tudsat-rocket/frodo_recovery_module/README.md

# Frodo Recovery Module

# Setup

Requires KiCAD version >= 6.0. To generate BOM, install the Interactive HTML BOM plugin: https://github.com/openscopeproject/InteractiveHtmlBom
