tudsat-rocket/frodo_recovery_module/ul_INA350ABSIDSGR/STEP/DSG0008A.stp

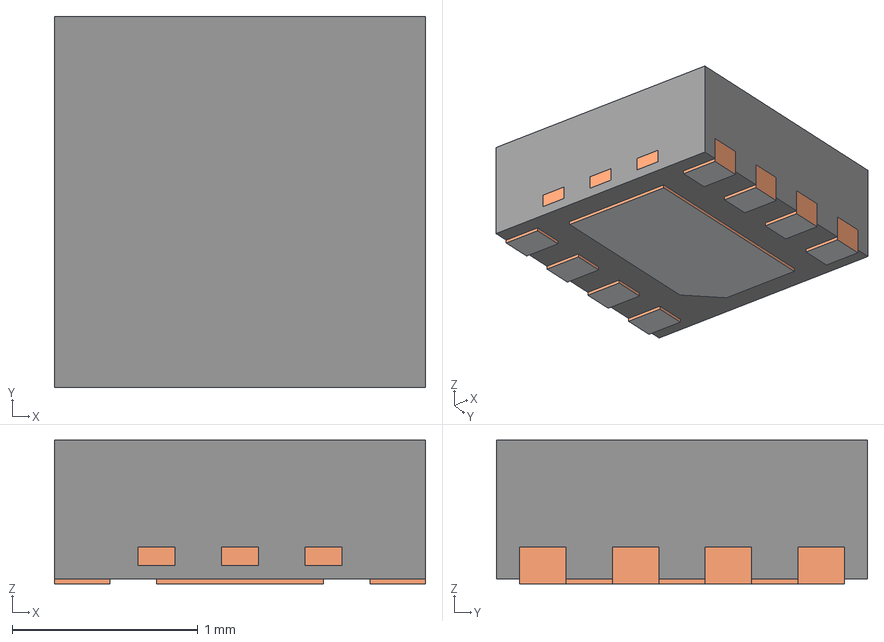
[picture p1: CAD file, 2023-07-11]
ul_INA350ABSIDSGR/STEP/DSG0008A.stp
2.00 x 2.00 x 0.775 mm
BODY-SON
FRAME-DSG0008A
PIN1-ID
