tudsat-rocket/frodo_recovery_module/3dmodels/EVQ-PUC02K.step

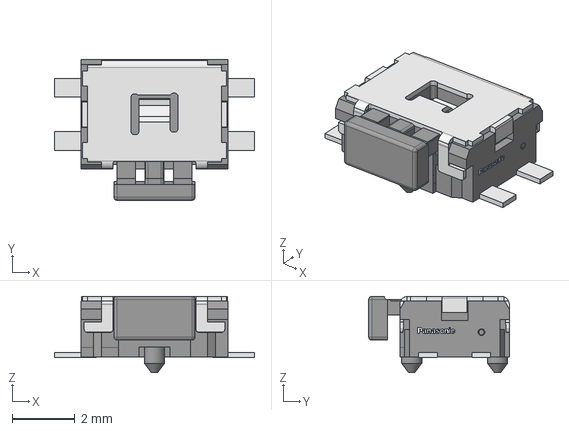
[picture p2: CAD file, 2023-07-11]
3dmodels/EVQ-PUC02K.step
6.40 x 4.50 x 2.44 mm
