tudsat-rocket/frodo_recovery_module/3dmodels/430450483.stp

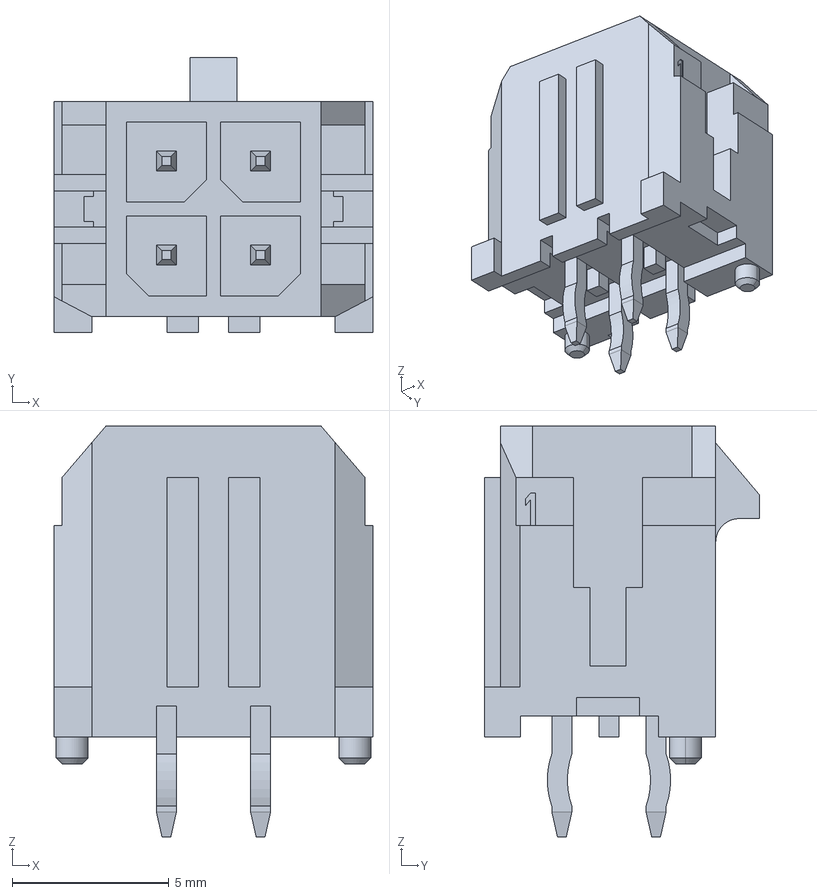
[picture p3: CAD file, 2023-07-11]
3dmodels/430450483.stp
10.2 x 8.77 x 13.1 mm
