tudsat-rocket/frodo_recovery_module/Recovery.kicad_pcb

## KiCad design Recovery.kicad_pcb (2023-07-17)

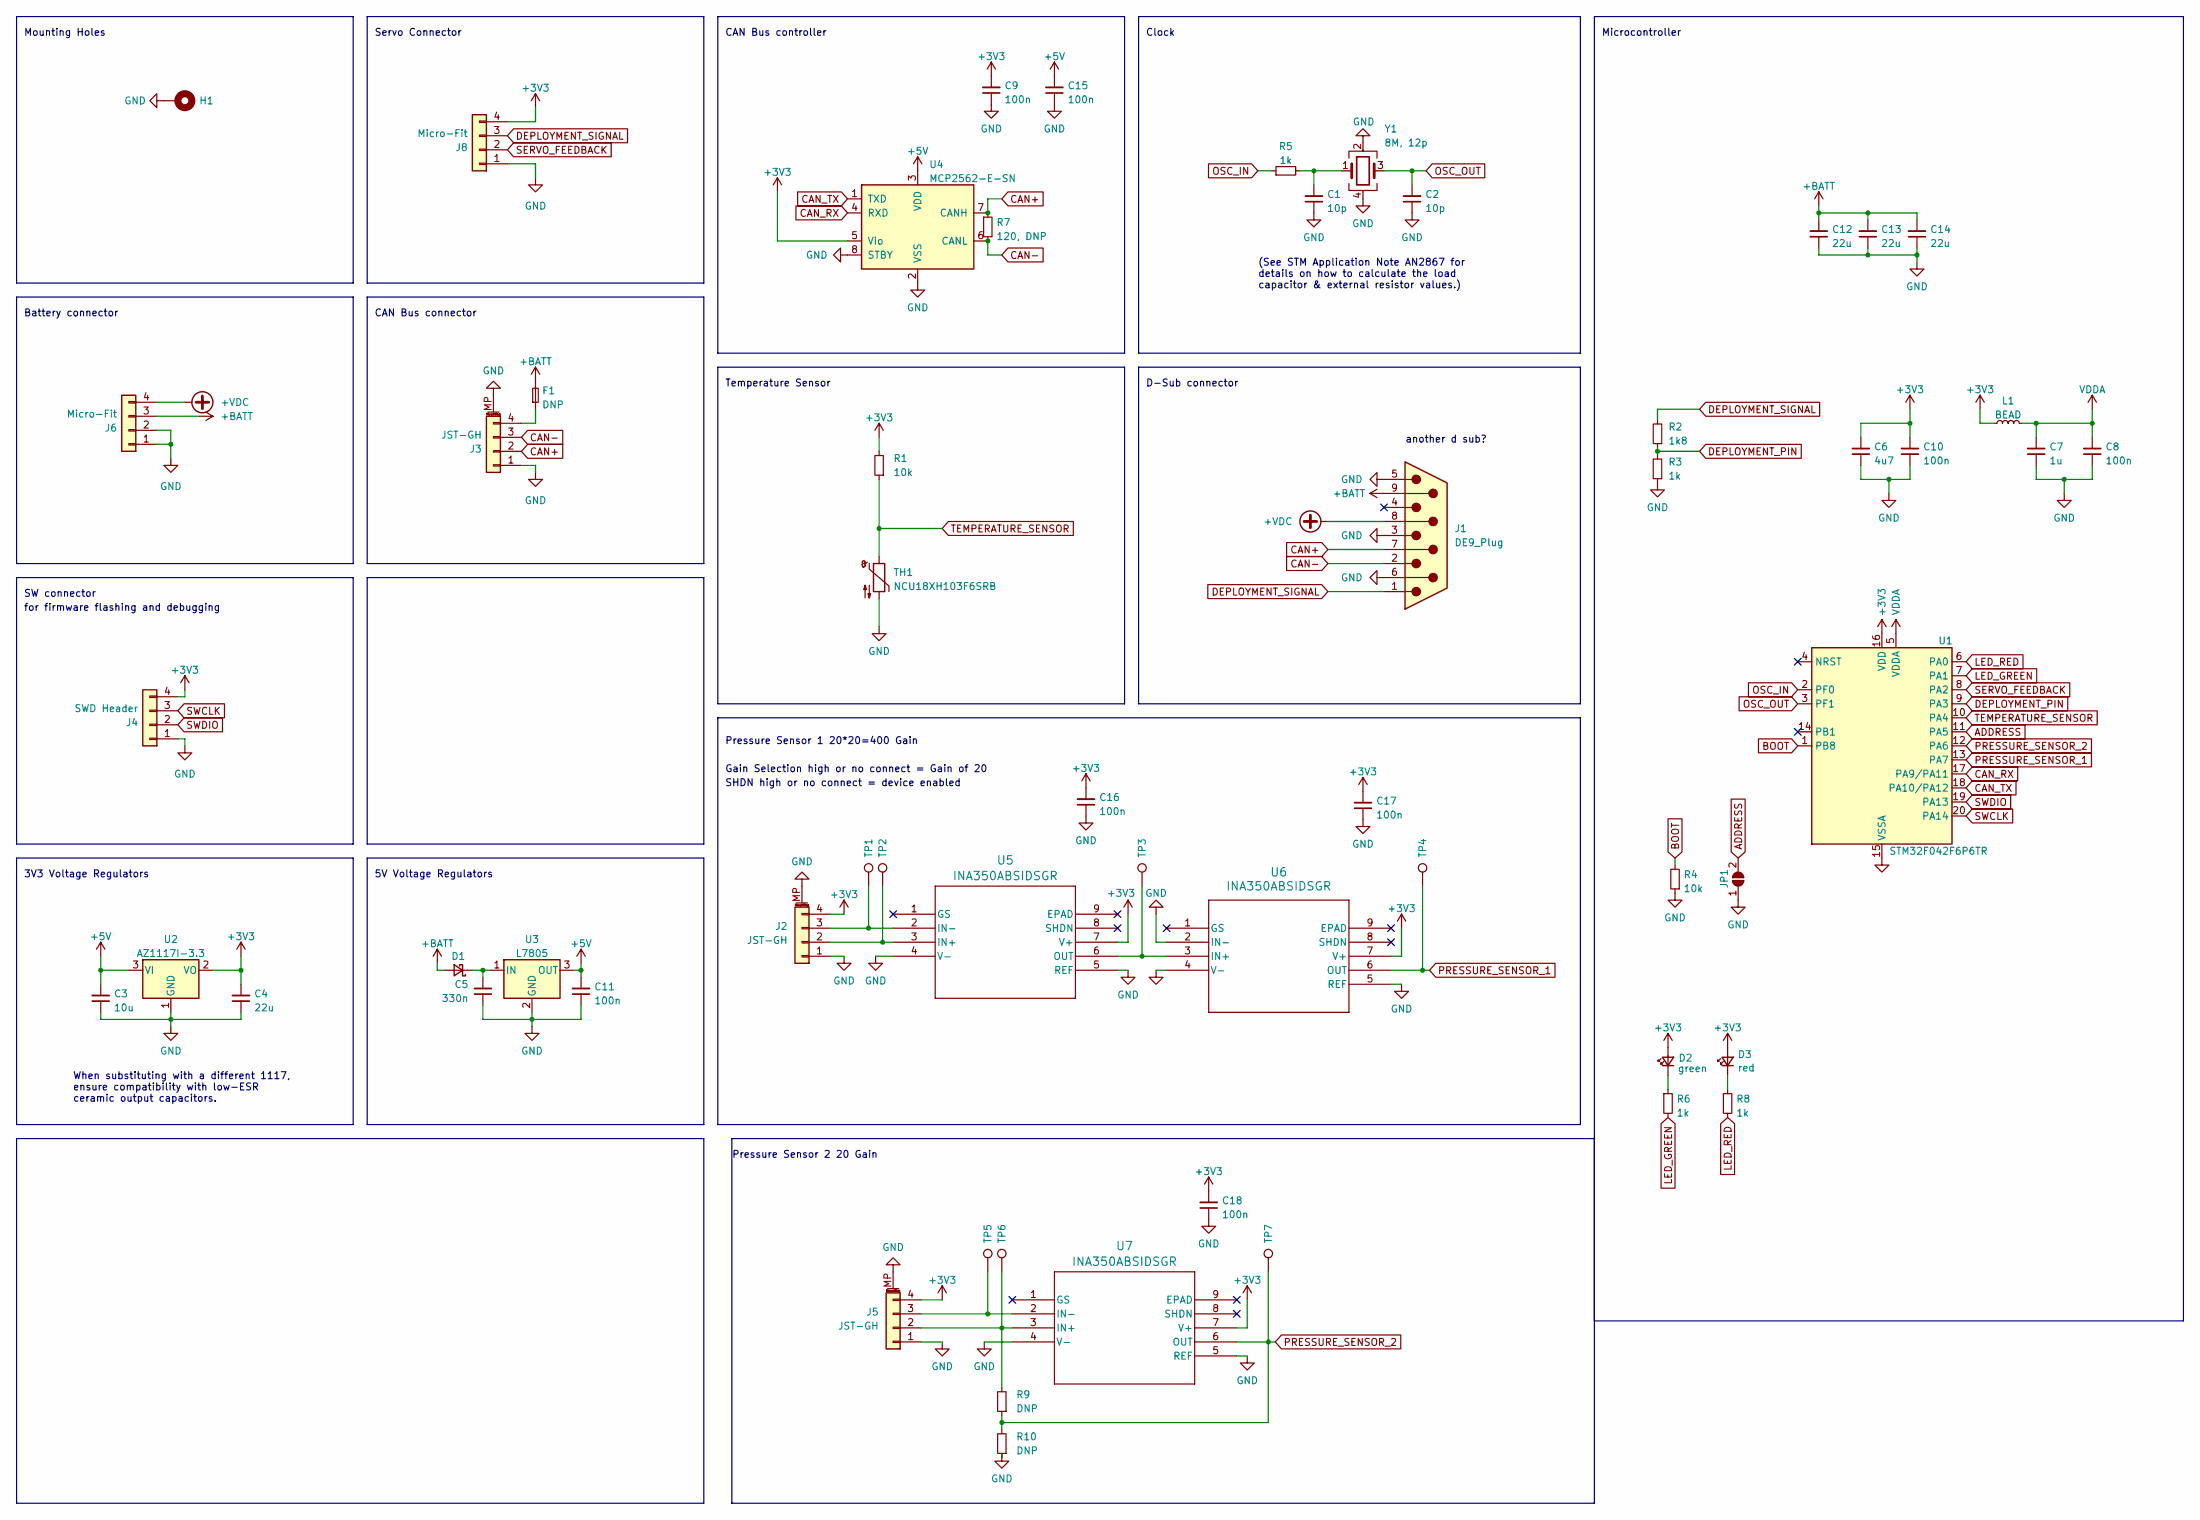
[picture p4: schematic Recovery.kicad_sch]

Parts:
C1, C2: 10p; C_0603_1608Metric; Part# CL10C100JB8NNNC; LCSC# C1634
C3: 10u; C_1206_3216Metric; Part# CL31B106KAHNNNE; LCSC# C14860
C4, C12, C13, C14: 22u; C_1206_3216Metric; Part# CL31A226KAHNNNE; LCSC# C12891
C5: 330n; C_0603_1608Metric; Part# CL10B334KO8NNNC; LCSC# C159798
C6: 4u7; C_1206_3216Metric; Part# CL31B475KAHNNNE; LCSC# C1872
C7: 1u; C_0805_2012Metric; Part# CL21A105KBCLNNC; LCSC# C318694
C8, C9, C10, C11, C15, C16, C17, C18: 100n; C_0603_1608Metric; Part# CL10B104KB8NNNC; LCSC# C1591
D1: D_SOD-123F; Part# PMEG3020EH,115; LCSC# C167645
D2: green; LED_0603_1608Metric; Part# 19-217/GHC-YR1S2/3T; LCSC# C72043
D3: red; LED_0603_1608Metric; Part# 19-213/RSC-BS2T2B/3T; LCSC# C474026
F1: DNP; Fuse_1206_3216Metric; Part# N/A; DigiKey# N/A
H1: MountingHole_Pad; MountingHole_2.2mm_M2_Pad; Part# N/A; DigiKey# N/A
J1: DE9_Plug; DSUB-9_Male_Vertical_P2.77x2.84mm_MountingHoles; Part# D09P24A4PL00LF; DigiKey# 609-5545-ND
J2, J3, J5: JST-GH; JST_GH_BM04B-GHS-TBT_1x04-1MP_P1.25mm_Vertical; Part# BM04B-GHS-TBT; LCSC# C161692
J4: SWD Header; PinHeader_1x04_P2.54mm_Vertical; Part# N/A; DigiKey# N/A
J6, J8: Micro-Fit; Molex_Micro-Fit_3.0_43045-0412_2x02_P3.00mm_Vertical; Part# 0430450412; DigiKey# WM1790-ND
JP1: SolderJumper_2_Open; SolderJumper-2_P1.3mm_Open_RoundedPad1.0x1.5mm; Part# N/A; DigiKey# N/A
L1: BEAD; L_0603_1608Metric; Part# BLM18AG601SN1D; LCSC# C19330
R1, R4: 10k; R_0603_1608Metric; Part# RC0603FR-0710KL; LCSC# C98220
R2: 1k8; R_0603_1608Metric; Part# RC0603FR-071K8L; LCSC# C185354
R3, R5, R6, R8: 1k; R_0603_1608Metric; Part# RC0603FR-071KL; LCSC# C22548
R7: 120, DNP; R_0603_1608Metric; Part# RC0603FR-07120RL; LCSC# C114640
R9, R10: DNP; R_0603_1608Metric; Part# N/A; DigiKey# N/A
TH1: NCU18XH103F6SRB; R_0603_1608Metric; Part# NCU18XH103F6SRB; DigiKey# 490-18139-1-ND
TP1, TP2, TP3, TP4, TP5, TP6, TP7: TestPoint; TestPoint_Pad_D2.0mm; Part# N/A; DigiKey# N/A
U1: STM32F042F6P6TR; TSSOP-20_4.4x6.5mm_P0.65mm; Part# STM32F042F6P6TR; DigiKey# 497-19656-1-ND
U2: AZ1117I-3.3; SOT-223-3_TabPin2; Part# AZ1117CH-3.3TRG1; LCSC# C92102
U3: L7805; TO-252-2; Part# L7805CDT-TR; LCSC# C310413
U4: MCP2562-E-SN; SOIC-8_3.9x4.9mm_P1.27mm; Part# MCP2562-H/SN; DigiKey# MCP2562-H/SN
U5, U6, U7: INA350ABSIDSGR; WSON8_DSG_TEX; Part# INA350ABSIDSGR; DigiKey# 296-INA350ABSIDSGRCT-ND
Y1: 8M, 12p; Oscillator_SMD_SeikoEpson_SG210-4Pin_2.5x2.0mm; Part# ECS-80-12-33-JGN-TR; DigiKey# 50-ECS-80-12-33-JGN-CT-ND

Connections:
+3V3: C4.2, C6.2, C9.2, C10.2, C16.2, C17.2, C18.2, D2.2 (A), D3.2 (A), J2.4, J4.4, J5.4, J8.4, L1.1, R1.2, U1.16 (VDD), U2.2 (VO), U4.5 (Vio), U5.7 (V+), U6.7 (V+), U7.7 (V+)
+5V: C3.2, C11.2, C15.2, U2.3 (VI), U3.3 (OUT), U4.3 (VDD)
+BATT: C12.2, C13.2, C14.2, D1.2 (A), F1.2, J1.9, J6.3
+VDC: J1.8, J6.4
ADDRESS: JP1.2 (B), U1.11 (PA5)
BOOT: R4.2, U1.1 (PB8)
CAN+: J1.7, J3.2, R7.1, U4.7 (CANH)
CAN-: J1.2, J3.3, R7.2, U4.6 (CANL)
CAN_RX: U1.17 (PA9/PA11), U4.4 (RXD)
CAN_TX: U1.18 (PA10/PA12), U4.1 (TXD)
DEPLOYMENT_PIN: R2.1, R3.2, U1.9 (PA3)
DEPLOYMENT_SIGNAL: J1.1, J8.3, R2.2
GND: C1.1, C2.1, C3.1, C4.1, C5.1, C6.1, C7.1, C8.1, C9.1, C10.1, C11.1, C12.1, C13.1, C14.1, C15.1, C16.1, C17.1, C18.1, H1.1, J1.3, J1.5, J1.6, J2.1, J2.MP (MountPin), J3.1, J3.MP (MountPin), J4.1, J5.1, J5.MP (MountPin), J6.1, J6.2, J8.1, JP1.1 (A), R3.1, R4.1, R10.1, TH1.2, U1.15 (VSSA), U2.1 (GND), U3.2 (GND), U4.2 (VSS), U4.8 (STBY), U5.4 (V-), U5.5 (REF), U6.2 (IN-), U6.4 (V-), U6.5 (REF), U7.4 (V-), U7.5 (REF), Y1.2, Y1.4
LED_GREEN: R6.2, U1.7 (PA1)
LED_RED: R8.2, U1.6 (PA0)
unnamed: C1.2, R5.2, Y1.1
unnamed: C5.2, D1.1 (K), U3.1 (IN)
unnamed: D2.1 (K), R6.1
unnamed: D3.1 (K), R8.1
unnamed: J2.2, TP2.1, U5.3 (IN+)
unnamed: J2.3, TP1.1, U5.2 (IN-)
unnamed: F1.1, J3.4
unnamed: J5.2, R9.2, TP6.1, U7.3 (IN+)
unnamed: J5.3, TP5.1, U7.2 (IN-)
unnamed: TP3.1, U5.6 (OUT), U6.3 (IN+)
OSC_IN: R5.1, U1.2 (PF0)
OSC_OUT: C2.2, U1.3 (PF1), Y1.3
PRESSURE_SENSOR_1: TP4.1, U1.13 (PA7), U6.6 (OUT)
PRESSURE_SENSOR_2: R9.1, R10.2, TP7.1, U1.12 (PA6), U7.6 (OUT)
SERVO_FEEDBACK: J8.2, U1.8 (PA2)
SWCLK: J4.3, U1.20 (PA14)
SWDIO: J4.2, U1.19 (PA13)
TEMPERATURE_SENSOR: R1.1, TH1.1, U1.10 (PA4)
VDDA: C7.2, C8.2, L1.2, U1.5 (VDDA)

Notes on the sheet:
Pressure Sensor 1 20*20=400 Gain
Battery connector
D-Sub connector
3V3 Voltage Regulators
CAN Bus controller
Servo Connector
Clock
When substituting with a different 1117, ensure compatibility with low-ESR ceramic output capacitors.
Microcontroller
Mounting Holes
for firmware flashing and debugging
SW connector
Temperature Sensor
(See STM Application Note AN2867 for details on how to calculate the load capacitor & external resistor values.)
Pressure Sensor 2 20 Gain
SHDN high or no connect = device enabled
another d sub?
5V Voltage Regulators
CAN Bus connector
Gain Selection high or no connect = Gain of 20

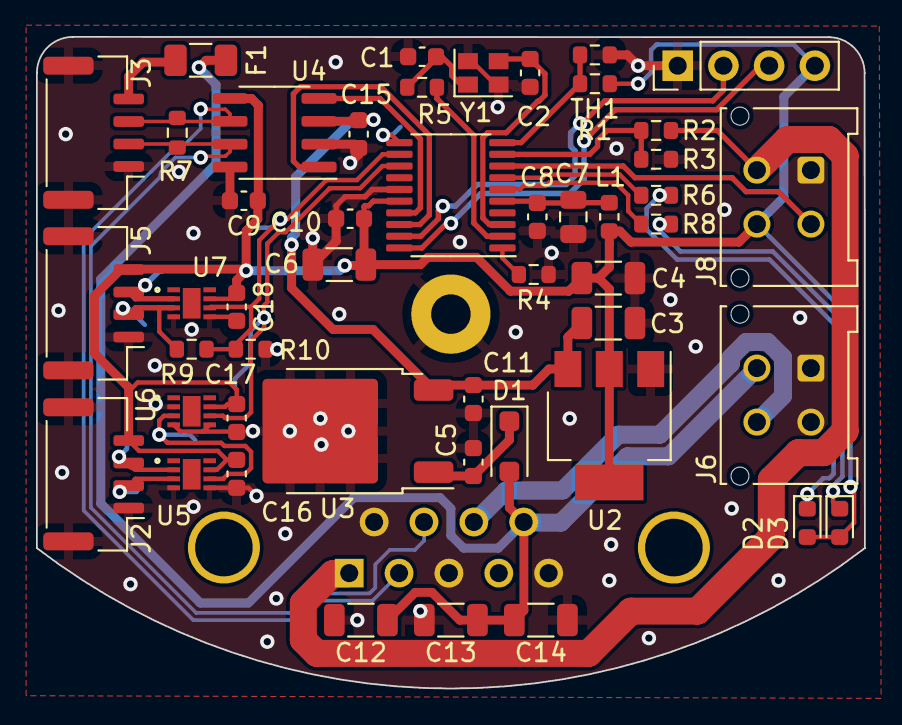
[picture p5: board Recovery.kicad_pcb from above]

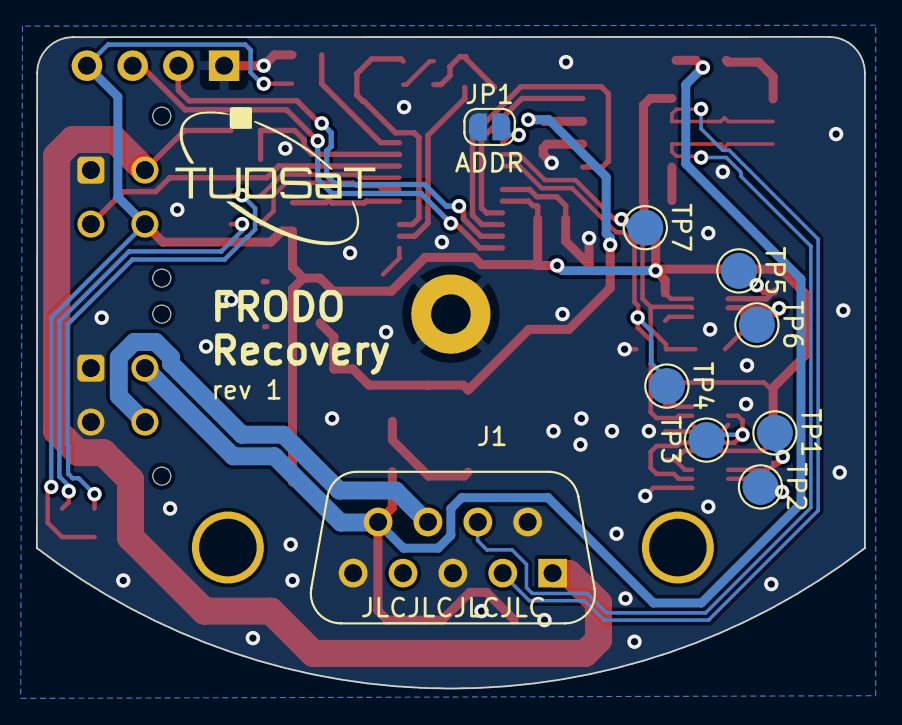
[picture p6: board Recovery.kicad_pcb from below]

Board: 2 copper layers, 46.0 x 36.2 mm, 58 parts (9 on the bottom side), 34 nets.
