tudsat-rocket/frodo_recovery_module/(commit log)

2023-06-09 organise schematic into sections
    [Recovery.kicad_sch]
2023-07-11 update pcb and schematic
    [430450483.stp, DSG0008A.stp, EVQ-PUC02K.step, MAXIM_90-100101.step, Molex_Picoflex_90325-0004_2x02_P1.27mm_Vertical.step, Recovery.kicad_pcb, Recovery.kicad_sch]
2023-07-12 fix pcb size
    [Recovery.kicad_pcb, Recovery.kicad_sch]
2023-07-13 finish traces
    [MAXIM_90-100101.step, Molex_Picoflex_90325-0004_2x02_P1.27mm_Vertical.step, Recovery.kicad_pcb, Recovery.kicad_sch]
2023-07-17 Various small fixes
    - increased trace width for deploy signal, removed thermal relief
    - left some room around screw, used pad hole type
    - tweaked CAN traces
    - Added bypass caps to amps, CAN controller
    - Removed 5V rail diode & LED, diode used for BAT instead
    - Used male D-Sub footprint instead of female (affects pin numbering)
    - Added test points for amps
    - Pulled BOOT pin low w/ 10k
    - Added a jumper to allow differentiating between top and bottom
    recovery
    - Add two MCU controllable LEDs
    - Added silkscreen (name, rev, logo)
    - Added oscillator values
    - Added a voltage-divider jumper for one sensor input
    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
    [Recovery.kicad_pcb, Recovery.kicad_sch]
